dz-enigmatologist/Photoglottography/(commit log)

2025-05-21 Added the correct code for arduino and lights flashing and sensor receive
    [arduino_code.ino]
2025-05-21 added device photo
2025-05-21 link to device photo is added
2025-05-21 added armoury that has latest stl files
